YTMartian/DecibelDetector/source/SoundMeter_Integrated_C3_595_REV4.kicad_pcb

## KiCad design source/SoundMeter_Integrated_C3_595_REV4.kicad_pcb (2026-10-27)

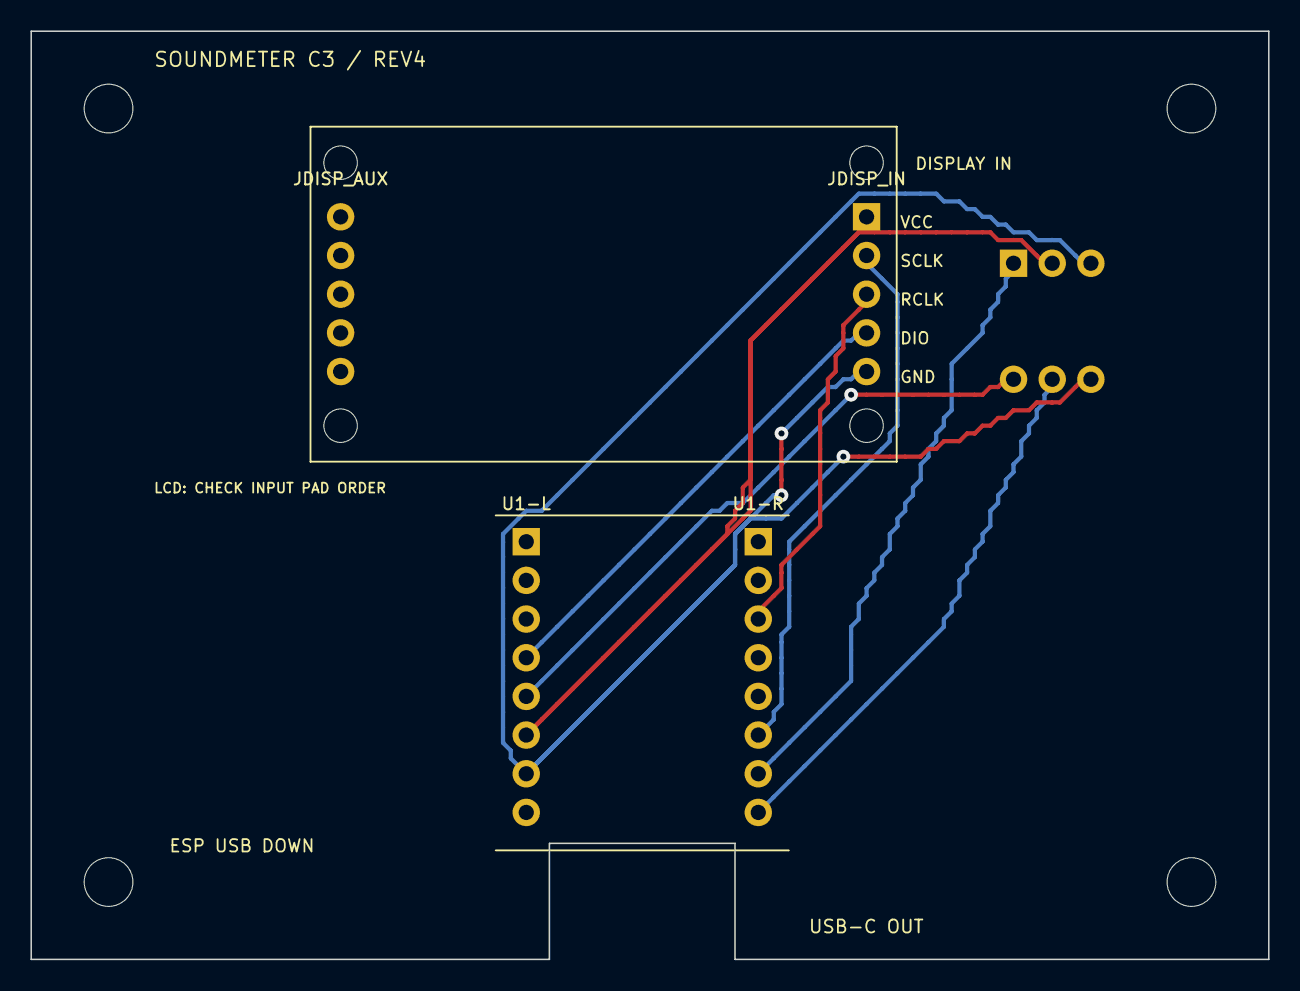
[picture p2: board SoundMeter_Integrated_C3_595_REV4.kicad_pcb from above]

Board: 2 copper layers, 81.3 x 61.0 mm, 13 parts (1 on the bottom side), 8 nets.

Parts:
D-M2-00, D-M2-01, D-M2-10, D-M2-11: MountingHole_2.2mm
H1, H2, H3, H4: MountingHole_3.2mm
JDISP_AUX: MODULE_SOCKET; JDISP_AUX
JDISP_IN: MODULE_SOCKET; JDISP_IN
JMIC: MODULE_SOCKET; JMIC
U1-L: MODULE_SOCKET; U1-L
U1-R: MODULE_SOCKET; U1-R

Connections:
3V3: JDISP_IN.VCC, JMIC.VDD, U1-L.3V3
DATA595: JDISP_IN.DIO, U1-L.GPIO3
GND: JDISP_IN.GND, JMIC.GND, JMIC.L/R, U1-L.GND
MIC_SCK: JMIC.SCK, U1-L.GPIO4
MIC_SD: JMIC.SD, U1-R.GPIO6
MIC_WS: JMIC.WS, U1-R.GPIO5
RCLK595: JDISP_IN.RCLK, U1-R.GPIO10
SCLK595: JDISP_IN.SCLK, U1-R.GPIO7
