YTMartian/DecibelDetector/(commit log)

2026-10-27 Initial commit: ESP32-C3 decibel detector (PCB v3, 74HC595, INMP441)
    [BOM.csv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]
2026-10-27 Bump firmware to v2.2 and reference probe v3
2026-10-27 更新pcb
    [BOM.csv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]
2026-10-27 Update README for REV4 integrated PCB
